l1h2/line_follower_stm/Core/Src/main.c

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
/* Includes ------------------------------------------------------------------*/
#include "main.h"

#include "gpio.h"
#include "spi.h"
#include "tim.h"
#include "usart.h"

/* USER CODE BEGIN Includes */
#include "state_machine/state_machine.h"

/* USER CODE END Includes */


void SystemClock_Config(void);
/**
 * @brief  The application entry point.
 * @retval int
 */
int main(void) {
    /* MCU
     * Configuration--------------------------------------------------------*/

    /* Reset of all peripherals, Initializes the Flash interface and the
     * Systick. */
    LL_APB2_GRP1_EnableClock(LL_APB2_GRP1_PERIPH_SYSCFG);
    LL_APB1_GRP1_EnableClock(LL_APB1_GRP1_PERIPH_PWR);

    /* System interrupt init*/
    NVIC_SetPriorityGrouping(NVIC_PRIORITYGROUP_4);

    /* SysTick_IRQn interrupt configuration */
    NVIC_SetPriority(SysTick_IRQn,
                     NVIC_EncodePriority(NVIC_GetPriorityGrouping(), 15, 0));

    /* Configure the system clock */
    SystemClock_Config();

    /* USER CODE BEGIN SysInit */
    /* Enable the ART accelerator: instruction cache, data cache and prefetch.
     * CubeMX emits PREFETCH_ENABLE / INSTRUCTION_CACHE_ENABLE /
     * DATA_CACHE_ENABLE as compile definitions, but only HAL_Init() consumes
     * them and this is an LL-only project, so they never take effect.
     * Valid as a plain OR only at boot: ACR resets to 0, so both caches are
     * already disabled and empty. */
    FLASH->ACR |= FLASH_ACR_ICEN | FLASH_ACR_DCEN | FLASH_ACR_PRFTEN;

    /* USER CODE END SysInit */

    /* Initialize all configured peripherals */
    MX_GPIO_Init();
    MX_USART1_UART_Init();
    MX_TIM2_Init();
    MX_TIM3_Init();
    MX_TIM4_Init();
    MX_SPI2_Init();
    /* USER CODE BEGIN 2 */

    run_state_machine();

    /* USER CODE END 2 */

    /* Infinite loop */
    /* USER CODE BEGIN WHILE */
    while (1) {
        /* USER CODE END WHILE */

        /* USER CODE BEGIN 3 */
    }
    /* USER CODE END 3 */
}

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
