l1h2/line_follower_stm/Core/Inc/main.h

#define LED_Pin LL_GPIO_PIN_13
#define LED_GPIO_Port GPIOC
#define MOTOR_RIGHT_IN_2_4_Pin LL_GPIO_PIN_14
#define MOTOR_RIGHT_IN_2_4_GPIO_Port GPIOC
#define MOTOR_RIGHT_IN_1_3_Pin LL_GPIO_PIN_15
#define MOTOR_RIGHT_IN_1_3_GPIO_Port GPIOC
#define MOTOR_LEFT_PWM_Pin LL_GPIO_PIN_1
#define MOTOR_LEFT_PWM_GPIO_Port GPIOA
#define MOTOR_RIGHT_PWM_Pin LL_GPIO_PIN_2
#define MOTOR_RIGHT_PWM_GPIO_Port GPIOA
#define TURBINE_PWM_Pin LL_GPIO_PIN_3
#define TURBINE_PWM_GPIO_Port GPIOA
#define SENSOR_IR_RIGHT_Pin LL_GPIO_PIN_4
#define SENSOR_IR_RIGHT_GPIO_Port GPIOA
#define SENSOR_IR_LEFT_Pin LL_GPIO_PIN_5
#define SENSOR_IR_LEFT_GPIO_Port GPIOA
#define MOTOR_LEFT_ENCODER_C2_Pin LL_GPIO_PIN_6
#define MOTOR_LEFT_ENCODER_C2_GPIO_Port GPIOA
#define MOTOR_LEFT_ENCODER_C1_Pin LL_GPIO_PIN_7
#define MOTOR_LEFT_ENCODER_C1_GPIO_Port GPIOA
#define SENSOR_IR_7_Pin LL_GPIO_PIN_0
#define SENSOR_IR_7_GPIO_Port GPIOB
#define SENSOR_IR_6_Pin LL_GPIO_PIN_1
#define SENSOR_IR_6_GPIO_Port GPIOB
#define SENSOR_IR_5_Pin LL_GPIO_PIN_10
#define SENSOR_IR_5_GPIO_Port GPIOB
#define MPU_NCS_Pin LL_GPIO_PIN_12
#define MPU_NCS_GPIO_Port GPIOB
#define MPU_SCL_Pin LL_GPIO_PIN_13
#define MPU_SCL_GPIO_Port GPIOB
#define MPU_ADO_Pin LL_GPIO_PIN_14
#define MPU_ADO_GPIO_Port GPIOB
#define MPU_SDA_Pin LL_GPIO_PIN_15
#define MPU_SDA_GPIO_Port GPIOB
#define SENSOR_IR_INPUT_Pin LL_GPIO_PIN_8
#define SENSOR_IR_INPUT_GPIO_Port GPIOA
#define BLUETOOTH_TX_Pin LL_GPIO_PIN_9
#define BLUETOOTH_TX_GPIO_Port GPIOA
#define BLUETOOTH_RX_Pin LL_GPIO_PIN_10
#define BLUETOOTH_RX_GPIO_Port GPIOA
#define MOTOR_LEFT_IN_2_4_Pin LL_GPIO_PIN_11
#define MOTOR_LEFT_IN_2_4_GPIO_Port GPIOA
#define MOTOR_LEFT_IN_1_3_Pin LL_GPIO_PIN_12
#define MOTOR_LEFT_IN_1_3_GPIO_Port GPIOA
#define SENSOR_IR_4_Pin LL_GPIO_PIN_3
#define SENSOR_IR_4_GPIO_Port GPIOB
#define SENSOR_IR_3_Pin LL_GPIO_PIN_4
#define SENSOR_IR_3_GPIO_Port GPIOB
#define SENSOR_IR_2_Pin LL_GPIO_PIN_5
#define SENSOR_IR_2_GPIO_Port GPIOB
#define MOTOR_RIGHT_ENCODER_C2_Pin LL_GPIO_PIN_6
#define MOTOR_RIGHT_ENCODER_C2_GPIO_Port GPIOB
#define MOTOR_RIGHT_ENCODER_C1_Pin LL_GPIO_PIN_7
#define MOTOR_RIGHT_ENCODER_C1_GPIO_Port GPIOB
#define SENSOR_IR_1_Pin LL_GPIO_PIN_8
#define SENSOR_IR_1_GPIO_Port GPIOB
#define SENSOR_IR_0_Pin LL_GPIO_PIN_9
#define SENSOR_IR_0_GPIO_Port GPIOB
#define NVIC_PRIORITYGROUP_0         ((uint32_t)0x00000007) /*!< 0 bit  for pre-emption priority,
#define NVIC_PRIORITYGROUP_1         ((uint32_t)0x00000006) /*!< 1 bit  for pre-emption priority,
#define NVIC_PRIORITYGROUP_2         ((uint32_t)0x00000005) /*!< 2 bits for pre-emption priority,
#define NVIC_PRIORITYGROUP_3         ((uint32_t)0x00000004) /*!< 3 bits for pre-emption priority,
#define NVIC_PRIORITYGROUP_4         ((uint32_t)0x00000003) /*!< 4 bits for pre-emption priority,
