l1h2/line_follower_stm/Core/pid/src/controllers/delta_pid.c

#include "pid/controllers/delta_pid.h"

#include <stddef.h>

#include "timer/time.h"

#define KP 80
#define KI 0
#define KD 4000
#define ALPHA 0.95f
#define CLAMP 100
#define FRAME_INTERVAL 1  // ms

static DeltaPid delta_pid = {
    .kp = KP,
    .ki = KI,
    .kd = KD,
    .alpha = ALPHA,
    .clamp = CLAMP,
    .frame_interval = FRAME_INTERVAL,
    .last_pid_time = 0,
};

static const ErrorStruct* errors = NULL;

static float filtered_delta_error = 0.0f;
static int16_t clamped_error_sum = 0;

static inline int16_t get_p(void) {
    if (delta_pid.kp == 0) return 0;

    return delta_pid.kp * errors->error;
}

static inline int32_t get_i(void) {
    if (delta_pid.ki == 0) return 0;

    clamped_error_sum += errors->error;
    if (clamped_error_sum > delta_pid.clamp) {
        clamped_error_sum = delta_pid.clamp;
    } else if (clamped_error_sum < -delta_pid.clamp) {
        clamped_error_sum = -delta_pid.clamp;
    }

    return (int32_t)delta_pid.ki * clamped_error_sum *
           (int32_t)delta_pid.frame_interval;
}

static inline int32_t get_d(void) {
    if (delta_pid.kd == 0) return 0;

    filtered_delta_error = delta_pid.alpha * errors->delta_error +
                           (1.0f - delta_pid.alpha) * filtered_delta_error;

    return (int32_t)((float)delta_pid.kd * filtered_delta_error /
                     (float)delta_pid.frame_interval);
}

const DeltaPid* init_delta_pwm_pid(const ErrorStruct* const error_struct) {
    errors = error_struct;
    return &delta_pid;
}

const DeltaPid* get_delta_pwm_pid_ptr(void) { return &delta_pid; }

int32_t get_delta_pwm_pid(void) { return get_p() + get_i() + get_d(); }

bool update_pending_delta_pwm_pid(void) {
    return time_elapsed(delta_pid.last_pid_time, delta_pid.frame_interval);
}

void update_delta_pwm_pid(void) { delta_pid.last_pid_time = time(); }

void clear_delta_pwm_pid(void) {
    filtered_delta_error = 0.0f;
    clamped_error_sum = 0;
}

void set_delta_pwm_kp(const uint8_t kp) { delta_pid.kp = kp; }

void set_delta_pwm_ki(const uint8_t ki) { delta_pid.ki = ki; }

void set_delta_pwm_kd(const uint16_t kd) { delta_pid.kd = kd; }

void set_delta_pwm_alpha(const float alpha) { delta_pid.alpha = alpha; }

void set_delta_pwm_clamp(const uint16_t clamp) { delta_pid.clamp = clamp; }
