l1h2/line_follower_stm/Core/track/src/track.c

#include "track/track.h"

#include <float.h>
#include <math.h>
#include <stddef.h>
#include <stdint.h>

#include "logger/logger.h"
#include "math/math.h"
#include "sensors/encoder.h"
#include "timer/time.h"
#include "track/observer.h"
#include "track/position_correction.h"

#define MIN_ARC_ANGLE_RAD 0.3f
#define IMU_FUSION_ALPHA 1.0f
#define DETECTION_DEBOUNCE_DISTANCE_CM 10.0f
#define MARKER_DISTANCE_THRESHOLD_CM 1.1f
#define MEMORY_GAP_DISTANCE_CM 2.0f
#define CROSSING_COUNTER_THRESHOLD 1
#define RIGHT_MARKER_DEBOUNCE_MS 30

static TrackCounters track = {0};

static const ErrorStruct* errors = NULL;
static float prev_mpu_yaw = 0.0f;
static bool heading_vec_initialized = false;

typedef enum { LINE, CROSSING, CURVE, MARKER } MemoryCounters;

static struct {
    uint8_t counter;
    MemoryCounters last;
    float distance;
    float last_distance;
} memory = {0, LINE, 0.0f, 0.0f};

static inline void reset_memory(void) {
    memory.counter = 0;
    memory.last = LINE;
    memory.distance = 0.0f;
}

static struct {
    float current;
    float step;
    float last_event;
} odometer = {0.0f, 0.0f, -FLT_MAX};

static inline void reset_odometer(void) {
    odometer.current = get_live_distance();
    odometer.step = 0.0f;
    odometer.last_event = -FLT_MAX;
}

static struct {
    bool active;
    uint32_t last_time;
} right_trigger = {false, 0};

static inline void reset_right_trigger(void) {
    right_trigger.active = false;
    right_trigger.last_time = 0;
}

static TrackTelemetry telemetry = {0};

static inline void reset_telemetry(void) { telemetry = (TrackTelemetry){0}; }

static inline void reset_headings(void) {
    track.sin_heading = 0.0f;
    track.cos_heading = 1.0f;
    prev_mpu_yaw = 0.0f;
    heading_vec_initialized = false;
}

static inline void complete_lap(void) {
    track.laps++;

    track.line_counter = 0;
    track.crossings = 0;
    track.curve_markers = 0;
    track.track_markers = 0;
    track.section = 0;

    // TODO: Get exact distance for track markers
    // track.x = -60;
    // track.y = 0;

    // reset_headings();
    reset_memory();
}

static inline void start_lap(void) {
    track.track_markers = 1;
    track.section = 1;

    track.line_counter = 0;
    track.crossings = 0;
    track.curve_markers = 0;

    // track.x = 0;
    // track.y = 0;

    // reset_headings();
    reset_memory();
}

static inline void anchor_heading_vector(const float heading) {
    track.cos_heading = cosf(heading);
    track.sin_heading = sinf(heading);
    track.heading = heading;
    heading_vec_initialized = true;
}

// TODO: Add distance resets based on markers
static inline void update_distance(void) {
    track.distance += errors->sensors->encoders->current_distance;
    if (track.distance < 0) track.distance = 0;
}

static inline float get_delta_angle(void) {
    const float enc_angle = errors->sensors->encoders->current_angle;
    const float current_yaw = errors->sensors->mpu_data->yaw;

    float delta_yaw = current_yaw - prev_mpu_yaw;
    normalize_angle(&delta_yaw);
    prev_mpu_yaw = current_yaw;

    return track.imu_alpha * delta_yaw + (1.0f - track.imu_alpha) * enc_angle;
}

// TODO: Add XY resets based on markers
static inline void update_position(void) {
    const float dist = errors->sensors->encoders->current_distance;
    const float angle = get_delta_angle();
    const float half_step = 0.5f * angle;

    if (!heading_vec_initialized) {
        anchor_heading_vector(errors->sensors->mpu_data->yaw - angle);
    }

    float s_half, c_half;
    if (fabsf(half_step) <= MIN_ARC_ANGLE_RAD) {
        sincos_poly_truncation(half_step, &s_half, &c_half);
    } else {
        s_half = sinf(half_step);
        c_half = cosf(half_step);
    }

    const float sin_h = track.sin_heading;
    float cos_h = track.cos_heading;

    const float cos_mid = cos_h * c_half - sin_h * s_half;
    const float sin_mid = sin_h * c_half + cos_h * s_half;

    track.x += dist * cos_mid;
    track.y += dist * sin_mid;

    const float s_full = 2.0f * s_half * c_half;
    const float c_full = c_half * c_half - s_half * s_half;

    track.cos_heading = cos_h * c_full - sin_h * s_full;
    track.sin_heading = sin_h * c_full + cos_h * s_full;
    normalize_unit_vector(&track.cos_heading, &track.sin_heading);

    track.heading += angle;
    normalize_angle(&track.heading);
}

static inline void update_line(void) {
    switch (check_line()) {
        case NONE:
            track.line_counter++;
            break;
        case LEFT:
            track.lost_left_counter++;
            break;
        case RIGHT:
            track.lost_right_counter++;
            break;
        case PITCH:
            track.lost_pitch_counter++;
            break;
    }
}

static inline void update_right_markers(void) {
    const bool active = errors->sensors->ir_sensors->right_sensor;
    const bool activated = active && !right_trigger.active;
    right_trigger.active = active;

    if (!activated ||
        !time_elapsed(right_trigger.last_time, RIGHT_MARKER_DEBOUNCE_MS)) {
        return;
    }

    right_trigger.last_time = time();
    track.right_markers++;
}

static inline void update_telemetry_right_sensor(void) {
    if (!errors->sensors->ir_sensors->right_sensor) return;
    telemetry.right_sensor = true;
}

static inline void update_odometer(void) {
    const float distance = get_live_distance();
    odometer.step = distance - odometer.current;
    odometer.current = distance;
}

static inline bool check_memory(const MemoryCounters counter_type) {
    if (counter_type != memory.last ||
        odometer.current - memory.last_distance > MEMORY_GAP_DISTANCE_CM) {
        reset_memory();
        memory.last = counter_type;
    }

    memory.last_distance = odometer.current;
    memory.counter++;
    memory.distance += odometer.step;

    if (counter_type == CROSSING) {
        if (memory.counter < CROSSING_COUNTER_THRESHOLD) return false;
    } else if (memory.distance < MARKER_DISTANCE_THRESHOLD_CM) {
        return false;
    }

    reset_memory();
    return true;
}

static inline void update_section_for_crossings(void) {
    if (track.section == 0) return;

    track.section++;
    debug_print("Crossing");
}

static inline void update_section_for_markers(void) {
    if (track.track_markers == 1) {
        start_lap();
    } else {
        complete_lap();
    }
    debug_print("Marker");
}

static inline bool process_event(const MemoryCounters event) {
    if (!check_memory(event)) return false;

    odometer.last_event = odometer.current;

    switch (event) {
        case CROSSING:
            track.crossings++;
            update_section_for_crossings();
            break;
        case CURVE:
            track.curve_markers++;
            break;
        case MARKER:
            track.track_markers++;
            update_section_for_markers();
            break;
        default:
            return false;
    }

    telemetry.event = (uint8_t)event;
    return true;
}

static inline bool update_track_counters(void) {
    update_odometer();

    if (odometer.current - odometer.last_event <
        DETECTION_DEBOUNCE_DISTANCE_CM) {
        return false;
    }

    if (check_non_contiguous_sensors()) return false;

    if (check_crossing() && process_event(CROSSING)) return true;
    if (check_curve_marker() && process_event(CURVE)) return true;
    if (check_track_marker() && process_event(MARKER)) return true;

    return false;
}

const TrackCounters* init_track(const ErrorStruct* const error_struct) {
    init_observer(error_struct);
    init_position_correction(&track);
    errors = error_struct;
    track.imu_alpha = IMU_FUSION_ALPHA;

    return &track;
}

const TrackCounters* get_track(void) { return &track; }

void reset_track(void) {
    const float imu_alpha = track.imu_alpha;
    track = (TrackCounters){0};
    track.imu_alpha = imu_alpha;

    reset_headings();
    reset_memory();
    reset_odometer();
    reset_right_trigger();
    reset_telemetry();
    reset_position_correction();
}

bool update_track(const bool encoder_updated) {
    if (encoder_updated) {
        update_distance();
        update_position();
    }

    update_line();
    update_right_markers();
    update_telemetry_right_sensor();
    return update_track_counters();
}

TrackTelemetry consume_track_telemetry(void) {
    const TrackTelemetry consumed = telemetry;
    reset_telemetry();
    return consumed;
}

void update_positions(void) {
    update_distance();
    update_position();
}

void apply_position_correction(const uint16_t lookahead_index) {
    float x_corr = 0.0f;
    float y_corr = 0.0f;

    get_correction(&x_corr, &y_corr, lookahead_index);

    track.x += x_corr;
    track.y += y_corr;
}

void set_imu_alpha(const float alpha) { track.imu_alpha = alpha; }
