l1h2/line_follower_stm/Core/state_machine/src/running_modes/running_encoder_test.c

#include "state_machine/running_modes/running_encoder_test.h"

#include "logger/logger.h"
#include "motors/motors.h"
#include "pid/pid.h"
#include "serial/serial_in.h"
#include "state_machine/running_modes/running_base.h"

#define ENCODER_TEST_DISTANCE_CM 100.0f

void running_encoder_test(const StateMachine* const sm) {
    debug_print("RUNNING_ENCODER_TEST Mode: Handling running logic");

    const PidStruct* pid = get_pid();

    start_turbine_if_needed();

    while (sm->can_run) {
        if (!update_speed_pid()) continue;

        debug_print_encoder_speeds();

        if (pid->errors->sensors->encoders->distance >=
            ENCODER_TEST_DISTANCE_CM) {
            debug_print("Reached target distance for encoder test");
            break;
        }

        process_serial_messages();
    }

    debug_print("Finalizing RUNNING_ENCODER_TEST mode");
}

void running_encoder_test_to_stopped(void) {
    set_motors(0, 0);
    stop_turbine_if_needed();
}
