l1h2/line_follower_stm/(commit log)

2025-10-02 Feat: Add encoder integration
2025-10-02 Refactor: Move motor control functions to separate motors module
2025-10-02 Refactor: Split PID controllers into multiple implementations to allow for different frame times when running
2025-10-03 Feat: Add encoder test with speed PID control
    Refactor: Move PID controllers and errors to their own subdirectories for better organization
    [base_pwm_pid.c, delta_pid.c, encoder.c, errors.c]
2025-10-03 Feat: PWM clamping for motor control when using the base speed PID, to account for mechanical differences between motors
2025-10-04 Feat: Add PID speed params to the serial protocol
2025-10-04 Feat: Add clamp and alpha filter to delta PWM PID controller
2025-10-05 Feat: Add log functions for floats and improve encoder variable debug prints
2025-10-12 Feat: Add track mapping in preparation to include pure pursuit running mode
2025-10-13 Fix: Pass positions in the protocol as signed integers instead of unsigned
    [serial_out.c]
2025-10-13 Chore: Remove STM auto-generated extension suggestions
    Fix: Change XY reset for when a lap is completed to predefined point
    [track.c]
2025-10-14 Fix: Implement fixes found during operation testing
    [pid.c, pure_pursuit.c, running_encoder_test.c, serial_in.c, serial_out.c]
2025-10-18 Refactor: Reorder protocol messages in better groups
    Feat: Add 4-digits decimal precision option for protocol messages
    Refactor: Make speed ki float instead of uint16_t
    Refactor: Break down debug prints for encoder information into multiple functions for easier selection of what to print
    Feat: Add ping messages to the serial protocol
2025-10-19 Refactor: Simplify parsing of protocol float messages
    Fix: Decouple sensor state management from error structure handling
    Refactor: Group pure pursuit state into a dedicated structure
    Feat: Add wheel base correction factor for improved odometry
    [encoder.c, errors.c, pure_pursuit.c, running.c, serial_in.c, serial_out.c]
2025-10-25 Feat: Add multiple checks to MPU-9250 initialization
    Fix: Correctly clear structs with stale data when restarting state machine operations
    Feat: Add gyroscope calibration for MPU-9250 and roll, pitch, yaw integrators
    Feat: Add degree and radian conversion functions
    Refactor: Break down MPU data printing into individual components
    [encoder.c, errors.c, logger_debug.c, mpu.c]
2025-10-25 Feat: Add MPU gyro to pure pursuit implementation
    Feat: Make imu infusion alpha and wheel base correction configurable in the serial protocol
    [encoder.c, pid.c, pure_pursuit.c, running_pure_pursuit.c]
2025-10-25 Feat: Add compile time track selection with a few test tracks
    Feat: Add KFF component to speed PID controller
    Fix: Remove speed PID guard clauses for 0 gains, as they were causing stale values to persist when gains were dynamically set to 0
    [config.h]
2025-10-26 Fix: Correct track selector imports
    [config.h]
2025-10-26 Fix: Change waypoint selection to avoid include confusion
    Feat: Add extra tracks
    [config.h]
2025-12-15 Docs: Update README
    [PINOS.xlsx]
2025-12-15 Docs: Update README with correct power supply information
2026-03-02 Fix: Change waypoint units from mm to cm so that it's compatible with the encoder variables
    [config.h]
2026-03-07 Chore: Update STM32Cube build version and project configuration generated by STM32CubeMX 6.17.0. This includes updates to the line_follower.ioc file and minor changes to the generated source files fo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
2026-09-09 Fix: Update effective wheel base calculation to use WHEEL_BASE_CM constant
    Fix: Correct TIM2 PWM frequency in README to 19.2 kHz
    [encoder.c]
2026-09-09 Fix: Change TXE interrupt handling to avoid race condition when flushing the last byte of the buffer. Now the interrupt self closes when the buffer is empty, instead of waiting for the next trigger t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
    Feat: Add asynchronous gyroscope calibration to avoid blocking the main loop during calibration and allow processing of serial messages to be handled by the state machine.
    Feat: Add ART accelerator enabling to the system initialization code to ensure instruction cache, data cache, and prefetch are enabled at boot time.
    Fix: Adjust I and D components of the Delta PID controller to use int32_t for calculations to prevent overflow and ensure correct behavior with larger values.
    [config.h, delta_pid.c, errors.c, main.c, mpu.c, pid.c]
2026-09-09 Feat: Add include paths and defines for STM32 project configuration so that the C/C++ plugin can provide accurate IntelliSense and code navigation without relying on the local CMake configuration.
2026-09-10 Fix: Change max_pwm type from uint8_t to uint16_t in running modes to fit the actual range of PWM values and prevent overflow issues.
    Fix: Add check for expected_size before reading buffer in serial_in to avoid incorrectly flushing the buffer when expected_size is zero, preventing potential data corruption.
    [running_pid.c, running_pure_pursuit.c, serial_in.c]
2026-09-10 Fix: Add update error option without winding PID so that modes that read the sensors on their own can still get the error as an observation.
    Fix: Move PWM update outside of get_new_pwm to avoid double update problem that was causing an acceleration bias in the right motor.
    [errors.c, pid.c, pure_pursuit.c]
2026-09-10 Fix: Small fixes in reset logic and float rounding for prints
    [logger_base.c, pid.c, speed_errors.c, track.c]
2026-09-10 Fix: Remove dropped function from previous commit
    [pid.c]
2026-09-10 Feat: Implement scaffolding for new position correction running mode
    [running.c]
2026-09-10 Refactor: Replace <stdlib.h> with <stddef.h> in files that don't require <stdlib.h> for memory allocation or other functions, ensuring proper inclusion of <stddef.h> for size_t and NULL definitions.
    [base_pwm_pid.c, delta_pid.c, errors.c, pid.c, pure_pursuit.c, running_base.c, sensors.c, speed_errors.c]
2026-09-11 Feat: Implement new position correction algorithm based on sensor readings and encoder position estimations
    [observer.c, position_correction.c]
2026-09-11 Feat: Finish wiring the new position correction algorithm to the associated running mode
    [position_correction.c, pure_pursuit.c, track.c]
2026-09-11 Refactor: Merge position correction into pure pursuit running mode to avoid unnecessary code duplication and improve maintainability.
    [pure_pursuit.c, running.c, running_pure_pursuit.c]
2026-09-22 Fix: Adjust memory counter checks to include threshold values, as the previous implementation was causing the 1 threshold value to be excluded from the checks, leading to incorrect behavior in certai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
    [track.c]
2026-09-22 Fix: Improve track event detection using live encoder distance to reduce false positives and debounce events based on distance traveled, instead of pre calibrated time intervals.
    [encoder.c, track.c]
2026-09-25 Fix: Set TIM3 and TIM4 input capture polarity to falling edge so that encoder signals are inverted to match the expected behavior of the line follower robot.
2026-09-25 Feat: Add PET 10 laps track with waypoints and header files
2026-10-10 Feat: Add deceleration step and stop motors in running modes.
2026-10-10 Fix: Rename CubeMX encoder labels to match motor sides.
2026-10-10 Refactor: Invert sensor order and correct error calculation to reflect new sensor orientation.
2026-10-25 Feat: Add PET_SMALL track configuration and header file.
2026-10-25 Fix: Update track selection to use PET_SMALL.
2026-10-25 Feat: Add error handling for track selection.
2026-10-26 Feat: Implement speed ramping for smoother acceleration to avoid left encoder missing pulses during fast acceleration at startup.
2026-10-26 Feat: Add new EXTENDED_DATA message to the protocol with relevant information when running pure pursuit in a 10 ms frame.
2026-10-27 Docs: Update track selection references in README.md to reflect new line numbers in config.h
2026-10-27 Feat: Implement error threshold for PID controller to prevent unnecessary braking.
2026-10-28 Chore: Update default values for PID and Pure Pursuit parameters.
